Zubax/mitochondrik-evaluation-board-lv/docs/figures/MEB-LV-jig.png

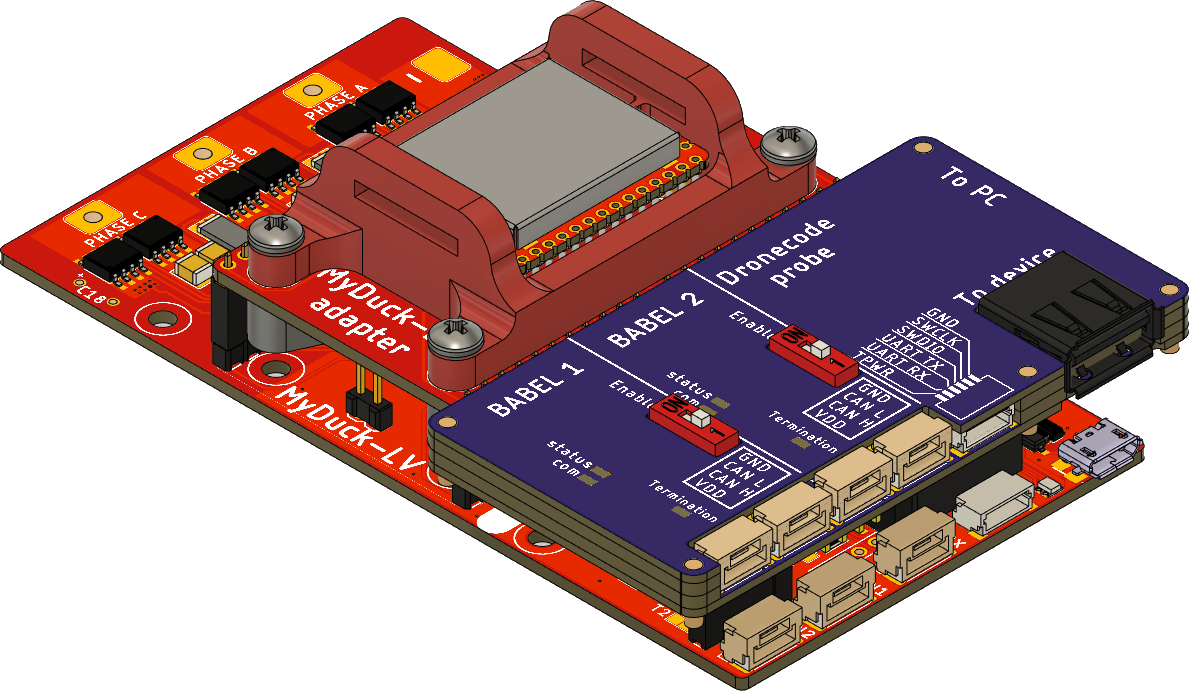
docs/figures/MEB-LV-jig.png
