Zubax/mitochondrik-evaluation-board-lv/figures/Myduck-LV-standalone.png

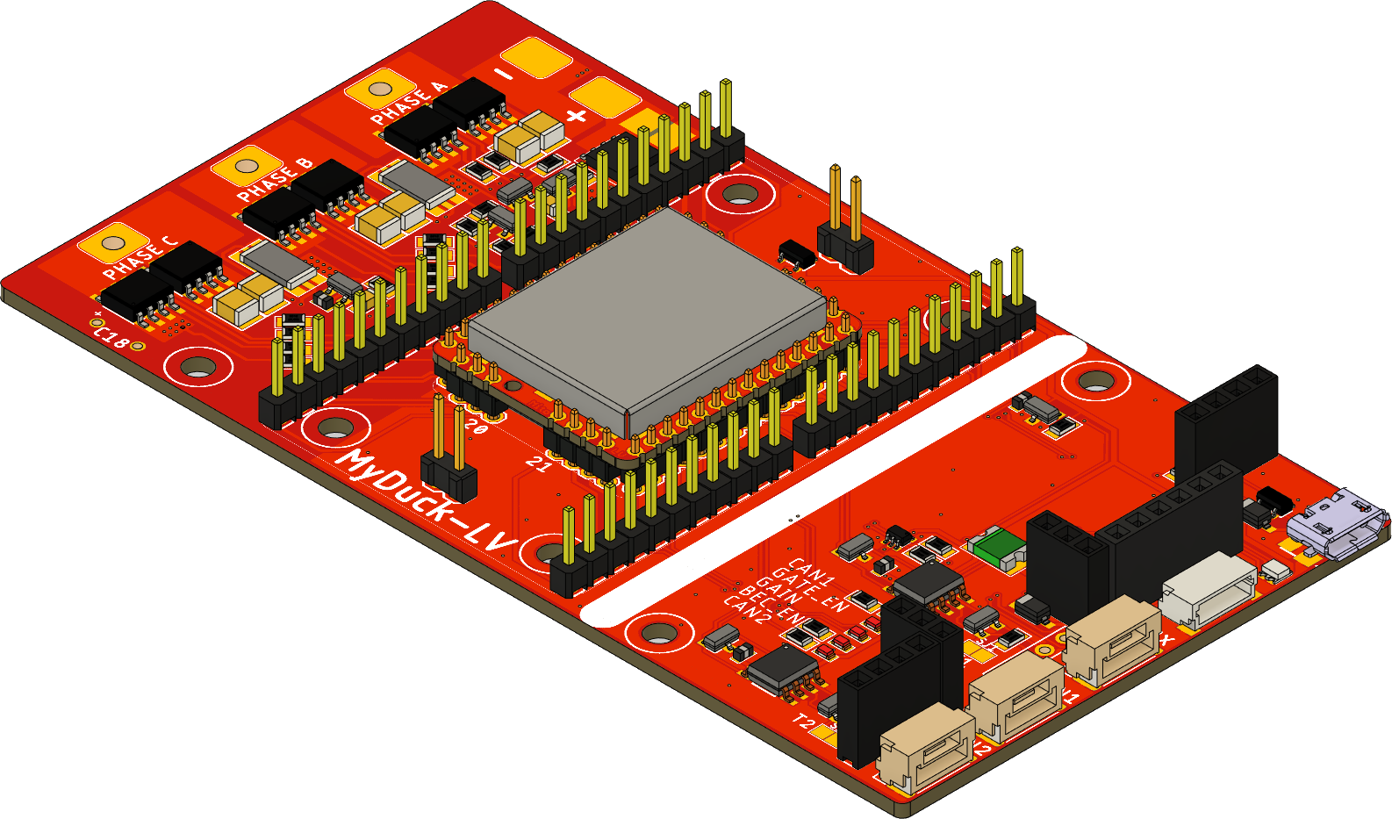
figures/Myduck-LV-standalone.png
