Zubax/mitochondrik-evaluation-board-lv/figures/toggle clamp.png

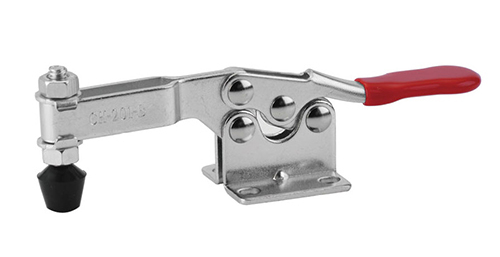
figures/toggle clamp.png
