Zubax/mitochondrik-evaluation-board-lv/3D/MEB_Holder_top.SLDPRT

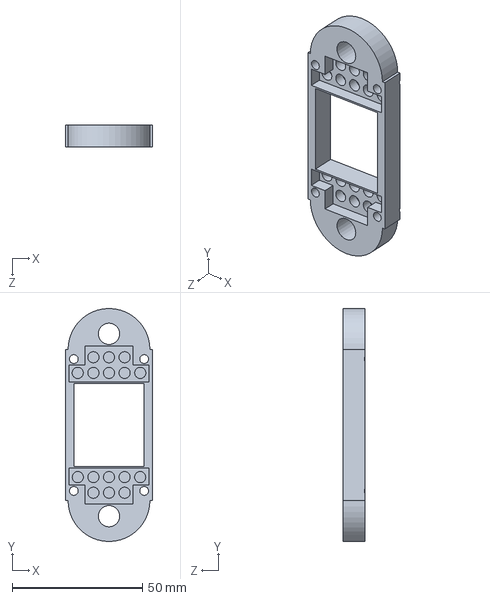
[picture p4: CAD file, 2023-08-01]
3D/MEB_Holder_top.SLDPRT
33.5 x 89.4 x 8.50 mm
