Zubax/mitochondrik-evaluation-board-lv/3D/MEB-Pogo-jig.SLDPRT

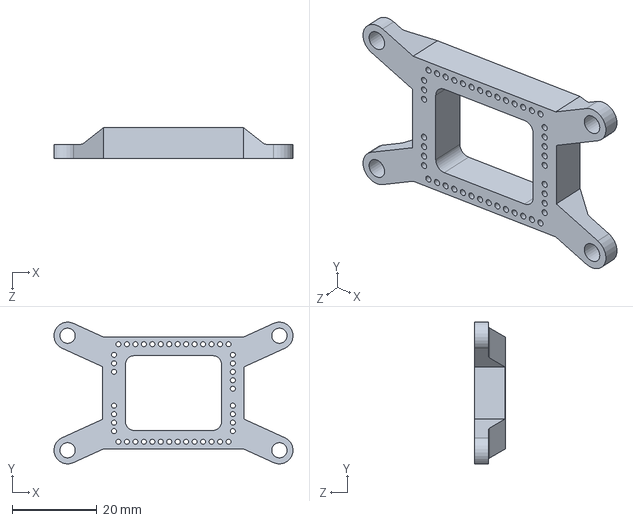
[picture p5: CAD file, 2023-05-10]
3D/MEB-Pogo-jig.SLDPRT
56.4 x 33.4 x 7.20 mm
