Zubax/mitochondrik-evaluation-board-lv/3D/MK_Holder_bottom.SLDPRT

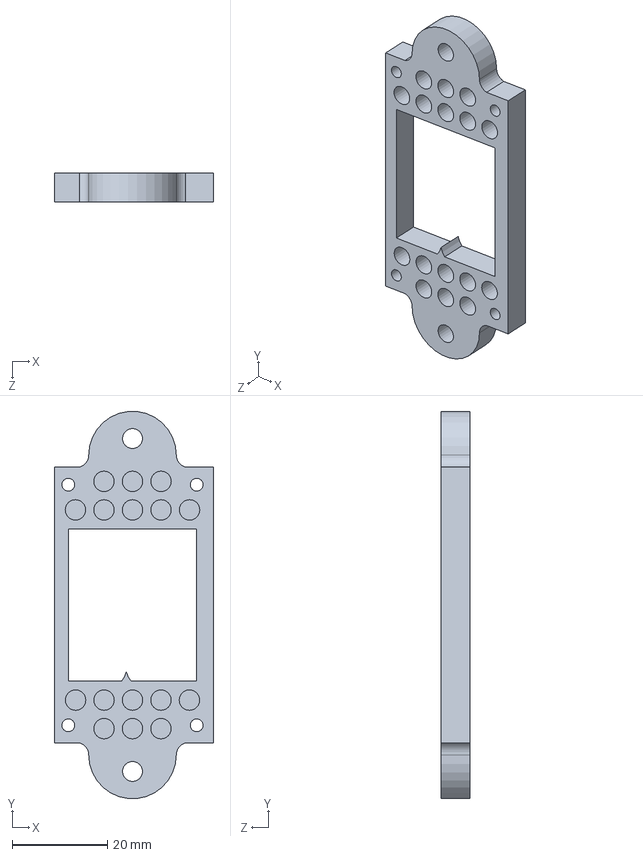
[picture p6: CAD file, 2023-03-03]
3D/MK_Holder_bottom.SLDPRT
33.5 x 81.4 x 6.00 mm
