Zubax/mitochondrik-evaluation-board-lv/docs/manufacturing.md

# Manufacturing instructions

## Evaluation board (customer variant)
Mitochondrik Evaluation Board LV can be used as an evaluation board for Mitochondrik LV. In this scenario, Mitochondrik LV is soldered 
directly to the PCB, turning Mitochondrik Evaluation Board LV into a debug-friendly evaluation board or a PMSM motor controller.

<p align="center">

</p>

To manufacture the device as an evaluation board, only the main PCB should be assembled.
The main PCB should be used to generate BOM and PnP files.
In addition, the DC link capacitor should be soldered beside `CON19` on the main PCB.
The RGB LED should be installed in the correct orientation. The reference photo can be seen below:

<p align="center">

</p>

As the mitochondrik footprint is populated using PLS2 male connectors,
the module installed on the PCB should be equipped with appropriate mating connectors.
The reference photo can be seen below.

<p align="center">

</p>

## Evaluation board with Babel-Babel (customer variant)
Same as above but with an integrated Babel-Babel. The footprint is populated using PLS 2.54 mm male connectors.
Ensure that Babel-Babel is parallel to the evaluation board when soldering.
The reference photo can be seen below.

<p align="center">
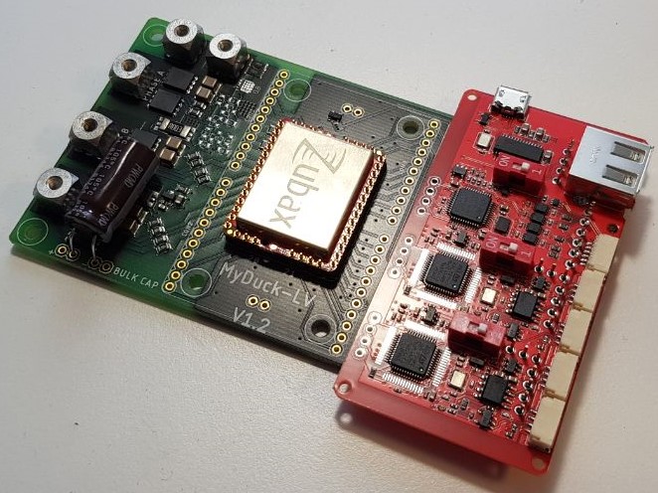
[picture p9: docs/figures/MEB-LV-EVAL-BB.jpeg]

</p>

## Production tool (manufacturer variant)

Mitochondrik Evaluation Board LV can serve as a tool for production flashing and testing of Mitochondrik LV (line checkout fixture).
In this scenario, the main board is assembled almost identically (mind the different assembly variant), and Mitochondrik LV is mounted on an intermediate PCB using pogo pins.
This PCB is then installed into Mitochondrik Evaluation Board LV.
Mitochondrik LV can be aligned in place using 3D-printed parts as explained below.
Mitochondrik Evaluation Board LV is designed to accept the [Babel-Babel debugging tool](https://github.com/Zubax/Babel-Babel) directly.

<p align="center">
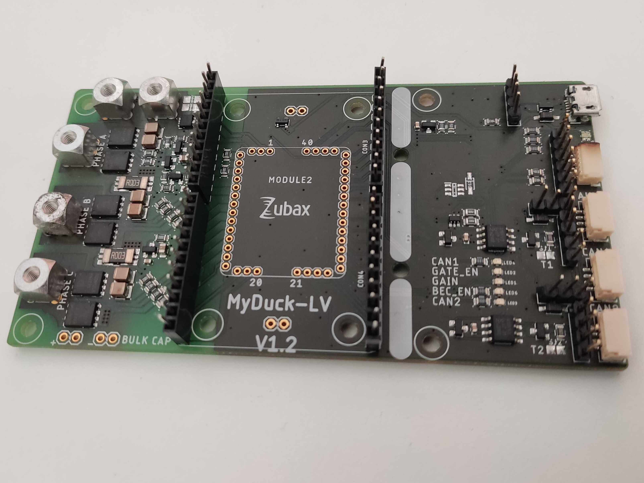
[picture p10: docs/figures/v1.2.jpg]


</p>

To use the device as a production tool, two PCBs should be manufactured. The main PCB should be used to generate
BOM and PnP files.

Besides that, the adapter PCB should also be manufactured. 
Solder 2 mm header pins & pogo pins to the adapter PCB.
It is permitted to use active flux for soldering the pogo pins; the part must be cleaned afterward.
Do not solder top-side pogo pins above the testpoints.

<p align="center">

</p>

A fully assembled adapter PCB can be seen in the pictures below.

<p align="center">
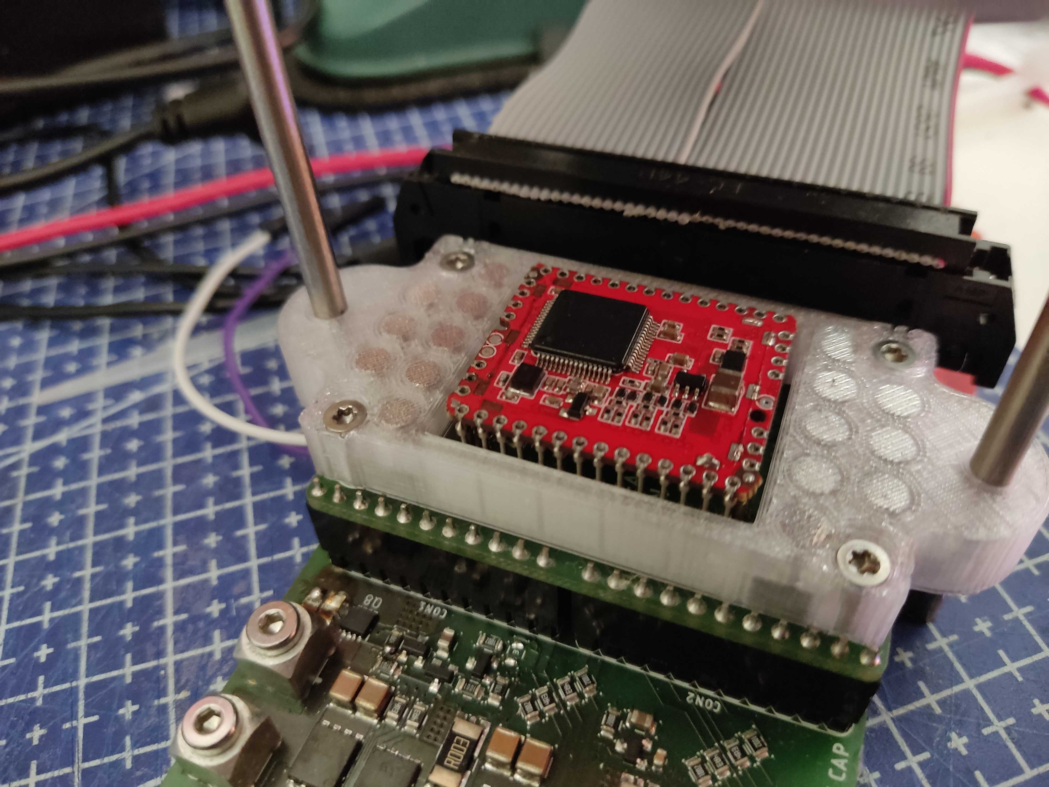
[picture p11: docs/figures/bottom-adapter.jpg]


</p>

Besides the 4x PBS11 connectors, the PCB also contains 44 pogo pins and a 3D-printed holder for the Mitochondrik module.
The pogo pins should be installed perpendicular to the surface of the PCB at the correct height.
As it may be tricky to do it by hand, it is recommended to use a special 3D-printed tool.
It can be seen in the picture below.

<p align="center">

</p>

The tool should be placed UNDER the PCB and aligned with all the holes on the PCB.
It can be temporarily fixed in place using M3 screws.
After that, the pins can be pushed into the tool through the PCB from the top.
The pins should be pushed until the lower tip of the pin is flush with the lower surface of the tool
(this guarantees the correct height of the pin relative to the top surface of the PCB).
After that, the pins can be soldered from the top side of the PCB.
The tool is single-use and cannot be removed from the device after the pins are mounted.
After the pogo pins are installed, the 3D-printed holder should be secured in place using 4x 8-12 mm M3 screws
and 4x M3 nuts.

The adapter set up can be seen below.

<p align="center">

</p>

Insert 4x4 mm magnets into the 3D Holders such that their magnetization direction alternates. 
Ensure that the top and bottom magnets attract each other.
Add 2 thin steel sheets to cover the magnet and close the flux.
Bolt the 3D Bottom Holder to the adapter board with 4x M3 screws from underneath. 
The steel plate should be in between the 3D holders and the adapter PCB.
Insert 4 mm metallic rods on both sides of the 3D Bottom Holder.
Assemble the second adapter board with pogo pins facing the opposite direction.
Ensure that the pogo pins of the top and bottom parts can make contact with each other
when the top part is pushed all the way down.
Bolt the 3D Top Holder to the second adapter board with 4x M3 screws from the top.
Insert linear bearings into the outer holes of the 3D Top Holder and apply glue.
Insert the 3D Top Holder and second adapter board assembly through the 4 mm metallic rods.
Connect the top and bottom adapter boards with a 1.27mm ribbon cable.

### BOM for final assembly of Mitochondrik Evaluation Board LV (customer variant)

| Name | Quantity |
| --- | --- |
| Mitochondrik Evaluation Board LV PCB | 1 |
| Mitochondrik LV | 1 |
| DC Link Capacitor: United Chemi-Con ELXZ630ELL821MK40S or Nichicon UPW1J221MPD1TD | 1 |
| PLS 2 mm male pin headers | 44 pins total | 
| PLS 2.54 mm male pin headers | 24 pins total |
| Babel-Babel (only for BB variant) | 1 | 

### BOM for final assembly of Mitochondrik Evaluation Board LV as production tool (manufacturer variant)

| Name | Quantity |
| --- | --- |
| Adapter assembly (Top & Bottom) | 2 |
| Mitochondrik Evaluation Board LV PCB | 1 |
| DC Link Capacitor: United Chemi-Con ELXZ630ELL821MK40S or Nichicon UPW1J221MPD1TD | 1 |
| PBS11 male connectors | 4 |
| PLS 2.54 mm male pin headers | 24 pins total |
| Babel-Babel | 1 |
| 4 mm linear guide | 2 |
| 4 mm linear bearing | 2 |
| 44 pin Ribbon connector | 1 |

### BOM required for the manufacturing of Top Adapter assembly

| Name | Quantity |
| --- | --- |
| Pogo pins soldering tool | 1 |  
| Pogo pins | 44 |
| Adapter PCB | 1 |
| 4x4 mm cylindrical axially-magnetized Neodymium magnets | 16 |
| 18x12.5x0.5 mm steel sheets | 2 |
| 3D Top Holder | 1 |
| M3 x 12mm screw | 4 | 
| M3 nut | 4 |

### BOM required for the manufacturing of Bottom Adapter assembly

| Name | Quantity |
| --- | --- |
| 3D Bottom Holder | 1 |
| 4x4 mm cylindrical axially-magnetized Neodymium magnets | 16 |
| 18x12.5x0.5 mm steel sheets | 2 |
| Adapter PCB | 1 |
| Pogo pins | 44 |
| Pogo pins soldering tool | 1 |  
| PBS11 female connectors  | 4 |
| M3 x 12mm screw | 4 | 
| M3 nut | 4 |
