Zubax/mitochondrik-evaluation-board-lv/src/adapter.brd

## EAGLE design src/adapter.brd (2023-05-10)

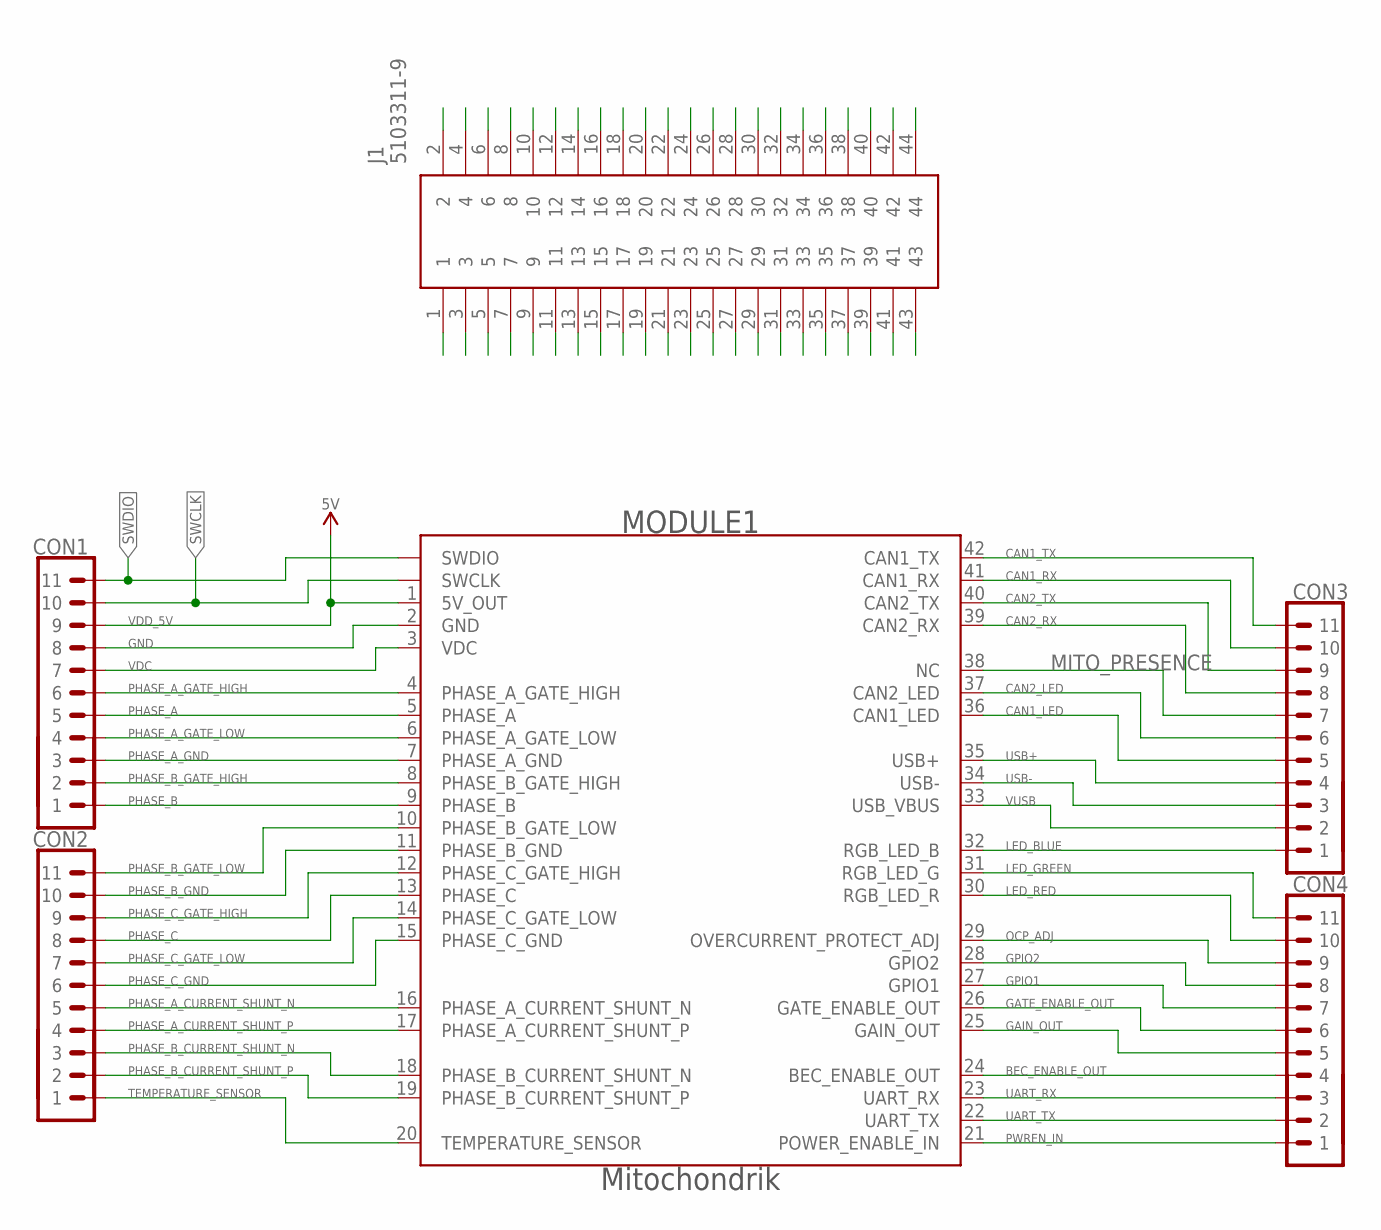
[picture p12: schematic adapter.sch, Mitochondrik]

Parts:
CON1, CON2, CON3, CON4: PINHEAD_1X11-2.54_STRAIGHT_FEMALE; 1X11-PTH-2.54-FEMALE; DIGIKEY# S7009-ND
J1: 5103311-9; SHDRRA44W66P254_2X22_6337X986X
MODULE1: MITOHONDRIQUE_POGO-POGO; MITOHONDRIQUE-POGO

Connections:
BEC_ENABLE_OUT: CON4.4, J1.37, MODULE1.24 (BEC_ENABLE_OUT)
CAN1_LED: CON3.5, J1.13, MODULE1.36 (CAN1_LED)
CAN1_RX: CON3.10, J1.3, MODULE1.41 (CAN1_RX)
CAN1_TX: CON3.11, J1.1, MODULE1.42 (CAN1_TX)
CAN2_LED: CON3.6, J1.11, MODULE1.37 (CAN2_LED)
CAN2_RX: CON3.8, J1.7, MODULE1.39 (CAN2_RX)
CAN2_TX: CON3.9, J1.5, MODULE1.40 (CAN2_TX)
GAIN_OUT: CON4.5, J1.35, MODULE1.25 (GAIN_OUT)
GATE_ENABLE_OUT: CON4.6, J1.33, MODULE1.26 (GATE_ENABLE_OUT)
GND: CON1.8, J1.8, MODULE1.2 (GND)
GPIO1: CON4.7, J1.31, MODULE1.27 (GPIO1)
GPIO2: CON4.8, J1.29, MODULE1.28 (GPIO2)
LED_BLUE: CON3.1, J1.21, MODULE1.32 (RGB_LED_B)
LED_GREEN: CON4.11, J1.23, MODULE1.31 (RGB_LED_G)
LED_RED: CON4.10, J1.25, MODULE1.30 (RGB_LED_R)
MITO_PRESENCE: CON3.7, J1.9, MODULE1.38 (NC)
OCP_ADJ: CON4.9, J1.27, MODULE1.29 (OVERCURRENT_PROTECT_ADJ)
PHASE_A: CON1.5, J1.14, MODULE1.5 (PHASE_A)
PHASE_A_CURRENT_SHUNT_N: CON2.5, J1.36, MODULE1.16 (PHASE_A_CURRENT_SHUNT_N)
PHASE_A_CURRENT_SHUNT_P: CON2.4, J1.38, MODULE1.17 (PHASE_A_CURRENT_SHUNT_P)
PHASE_A_GATE_HIGH: CON1.6, J1.12, MODULE1.4 (PHASE_A_GATE_HIGH)
PHASE_A_GATE_LOW: CON1.4, J1.16, MODULE1.6 (PHASE_A_GATE_LOW)
PHASE_A_GND: CON1.3, J1.18, MODULE1.7 (PHASE_A_GND)
PHASE_B: CON1.1, J1.22, MODULE1.9 (PHASE_B)
PHASE_B_CURRENT_SHUNT_N: CON2.3, J1.40, MODULE1.18 (PHASE_B_CURRENT_SHUNT_N)
PHASE_B_CURRENT_SHUNT_P: CON2.2, J1.42, MODULE1.19 (PHASE_B_CURRENT_SHUNT_P)
PHASE_B_GATE_HIGH: CON1.2, J1.20, MODULE1.8 (PHASE_B_GATE_HIGH)
PHASE_B_GATE_LOW: CON2.11, J1.24, MODULE1.10 (PHASE_B_GATE_LOW)
PHASE_B_GND: CON2.10, J1.26, MODULE1.11 (PHASE_B_GND)
PHASE_C: CON2.8, J1.30, MODULE1.13 (PHASE_C)
PHASE_C_GATE_HIGH: CON2.9, J1.28, MODULE1.12 (PHASE_C_GATE_HIGH)
PHASE_C_GATE_LOW: CON2.7, J1.32, MODULE1.14 (PHASE_C_GATE_LOW)
PHASE_C_GND: CON2.6, J1.34, MODULE1.15 (PHASE_C_GND)
PWREN_IN: CON4.1, J1.43, MODULE1.21 (POWER_ENABLE_IN)
SWCLK: CON1.10, J1.4, MODULE1.SWCLK
SWDIO: CON1.11, J1.2, MODULE1.SWDIO
TEMPERATURE_SENSOR: CON2.1, J1.44, MODULE1.20 (TEMPERATURE_SENSOR)
UART_RX: CON4.3, J1.39, MODULE1.23 (UART_RX)
UART_TX: CON4.2, J1.41, MODULE1.22 (UART_TX)
USB+: CON3.4, J1.15, MODULE1.35 (USB+)
USB-: CON3.3, J1.17, MODULE1.34 (USB-)
VDC: CON1.7, J1.10, MODULE1.3 (VDC)
VDD_5V: CON1.9, J1.6, MODULE1.1 (5V_OUT)
VUSB: CON3.2, J1.19, MODULE1.33 (USB_VBUS)

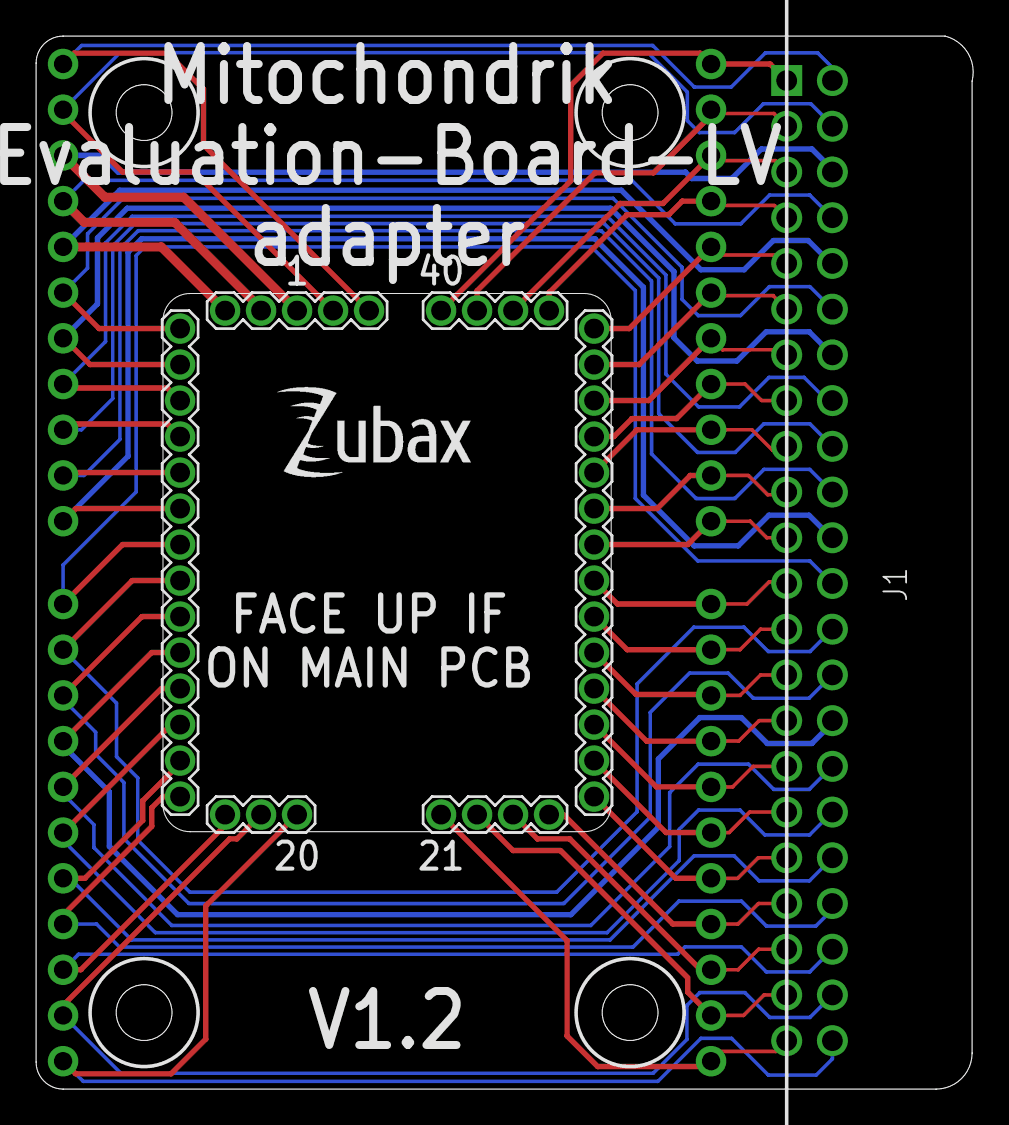
[picture p13: board adapter.brd from above]

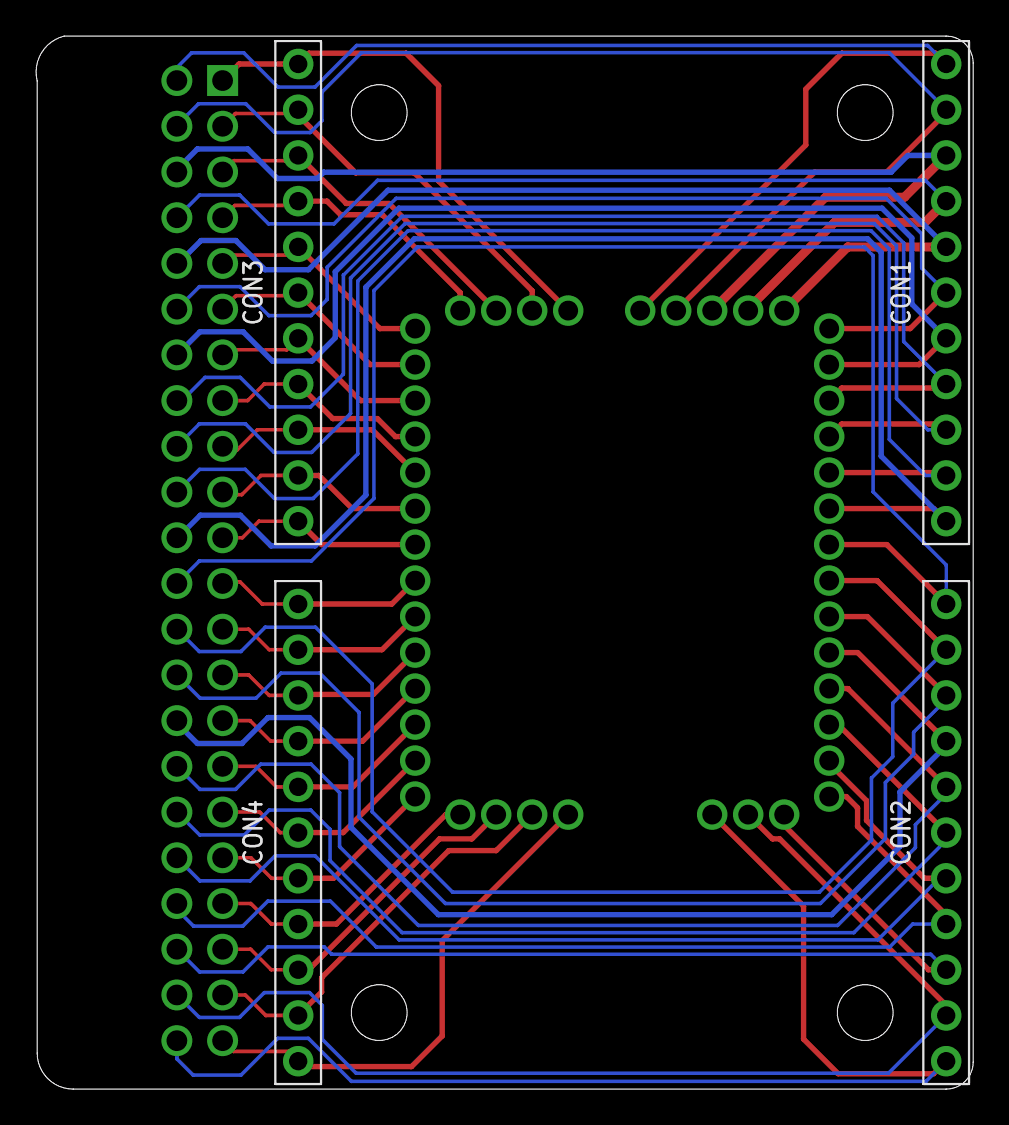
[picture p14: board adapter.brd from below]

Board: 2 copper layers, 52.1 x 58.5 mm, 7 parts (4 on the bottom side), 44 nets.

Other parts of the board:
U$2: ZUBAX_LOGO_5X10
