Zubax/mitochondrik-evaluation-board-lv/src/MyDuck-LV.brd

## EAGLE design src/MyDuck-LV.brd (2023-03-10)

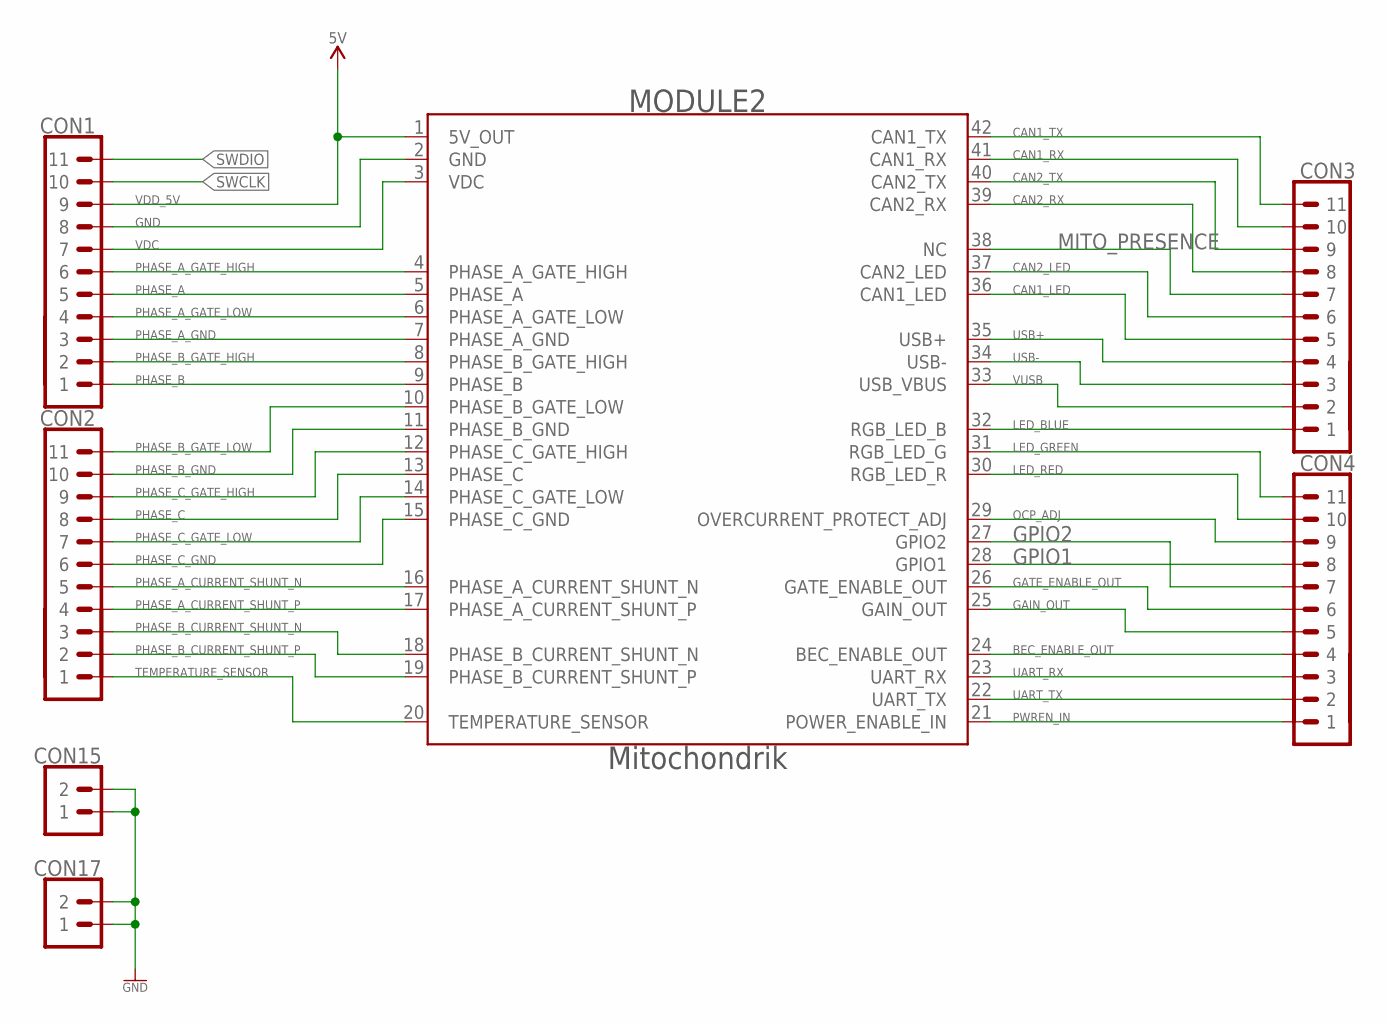
[picture p15: schematic MyDuck-LV.sch, sheet 1, Mitochondrik]

Parts:
CON1, CON2, CON3, CON4: PINHEAD_1X11-2.54_STRAIGHT_MALE; 1X11-PTH-2.54; DIGIKEY# S1022EC-11-ND
CON15, CON17: PINHEAD_1X02-2.54; 1X02-PTH-2.54; DIGIKEY# S1041E-02-ND
MODULE2: MITOCHONDRIK

Connections:
BEC_ENABLE_OUT: CON4.4, MODULE2.24 (BEC_ENABLE_OUT); also elsewhere on the board
CAN1_LED: CON3.5, MODULE2.36 (CAN1_LED); also elsewhere on the board
CAN1_RX: CON3.10, MODULE2.41 (CAN1_RX); also elsewhere on the board
CAN1_TX: CON3.11, MODULE2.42 (CAN1_TX); also elsewhere on the board
CAN2_LED: CON3.6, MODULE2.37 (CAN2_LED); also elsewhere on the board
CAN2_RX: CON3.8, MODULE2.39 (CAN2_RX); also elsewhere on the board
CAN2_TX: CON3.9, MODULE2.40 (CAN2_TX); also elsewhere on the board
GAIN_OUT: CON4.5, MODULE2.25 (GAIN_OUT); also elsewhere on the board
GATE_ENABLE_OUT: CON4.6, MODULE2.26 (GATE_ENABLE_OUT); also elsewhere on the board
GND: CON1.8, CON15.1, CON15.2, CON17.1, CON17.2, MODULE2.2 (GND); also elsewhere on the board
GPIO1: CON4.8, MODULE2.28 (GPIO1); also elsewhere on the board
GPIO2: CON4.7, MODULE2.27 (GPIO2); also elsewhere on the board
LED_BLUE: CON3.1, MODULE2.32 (RGB_LED_B); also elsewhere on the board
LED_GREEN: CON4.11, MODULE2.31 (RGB_LED_G); also elsewhere on the board
LED_RED: CON4.10, MODULE2.30 (RGB_LED_R); also elsewhere on the board
MITO_PRESENCE: CON3.7, MODULE2.38 (NC); also elsewhere on the board
OCP_ADJ: CON4.9, MODULE2.29 (OVERCURRENT_PROTECT_ADJ)
PHASE_A: CON1.5, MODULE2.5 (PHASE_A); also elsewhere on the board
PHASE_A_CURRENT_SHUNT_N: CON2.5, MODULE2.16 (PHASE_A_CURRENT_SHUNT_N); also elsewhere on the board
PHASE_A_CURRENT_SHUNT_P: CON2.4, MODULE2.17 (PHASE_A_CURRENT_SHUNT_P); also elsewhere on the board
PHASE_A_GATE_HIGH: CON1.6, MODULE2.4 (PHASE_A_GATE_HIGH); also elsewhere on the board
PHASE_A_GATE_LOW: CON1.4, MODULE2.6 (PHASE_A_GATE_LOW); also elsewhere on the board
PHASE_A_GND: CON1.3, MODULE2.7 (PHASE_A_GND); also elsewhere on the board
PHASE_B: CON1.1, MODULE2.9 (PHASE_B); also elsewhere on the board
PHASE_B_CURRENT_SHUNT_N: CON2.3, MODULE2.18 (PHASE_B_CURRENT_SHUNT_N); also elsewhere on the board
PHASE_B_CURRENT_SHUNT_P: CON2.2, MODULE2.19 (PHASE_B_CURRENT_SHUNT_P); also elsewhere on the board
PHASE_B_GATE_HIGH: CON1.2, MODULE2.8 (PHASE_B_GATE_HIGH); also elsewhere on the board
PHASE_B_GATE_LOW: CON2.11, MODULE2.10 (PHASE_B_GATE_LOW); also elsewhere on the board
PHASE_B_GND: CON2.10, MODULE2.11 (PHASE_B_GND); also elsewhere on the board
PHASE_C: CON2.8, MODULE2.13 (PHASE_C); also elsewhere on the board
PHASE_C_GATE_HIGH: CON2.9, MODULE2.12 (PHASE_C_GATE_HIGH); also elsewhere on the board
PHASE_C_GATE_LOW: CON2.7, MODULE2.14 (PHASE_C_GATE_LOW); also elsewhere on the board
PHASE_C_GND: CON2.6, MODULE2.15 (PHASE_C_GND); also elsewhere on the board
PWREN_IN: CON4.1, MODULE2.21 (POWER_ENABLE_IN)
SWCLK: CON1.10; also elsewhere on the board
SWDIO: CON1.11; also elsewhere on the board
TEMPERATURE_SENSOR: CON2.1, MODULE2.20 (TEMPERATURE_SENSOR); also elsewhere on the board
UART_RX: CON4.3, MODULE2.23 (UART_RX); also elsewhere on the board
UART_TX: CON4.2, MODULE2.22 (UART_TX); also elsewhere on the board
USB+: CON3.4, MODULE2.35 (USB+); also elsewhere on the board
USB-: CON3.3, MODULE2.34 (USB-); also elsewhere on the board
VDC: CON1.7, MODULE2.3 (VDC); also elsewhere on the board
VDD_5V: CON1.9, MODULE2.1 (5V_OUT); also elsewhere on the board
VUSB: CON3.2, MODULE2.33 (USB_VBUS); also elsewhere on the board

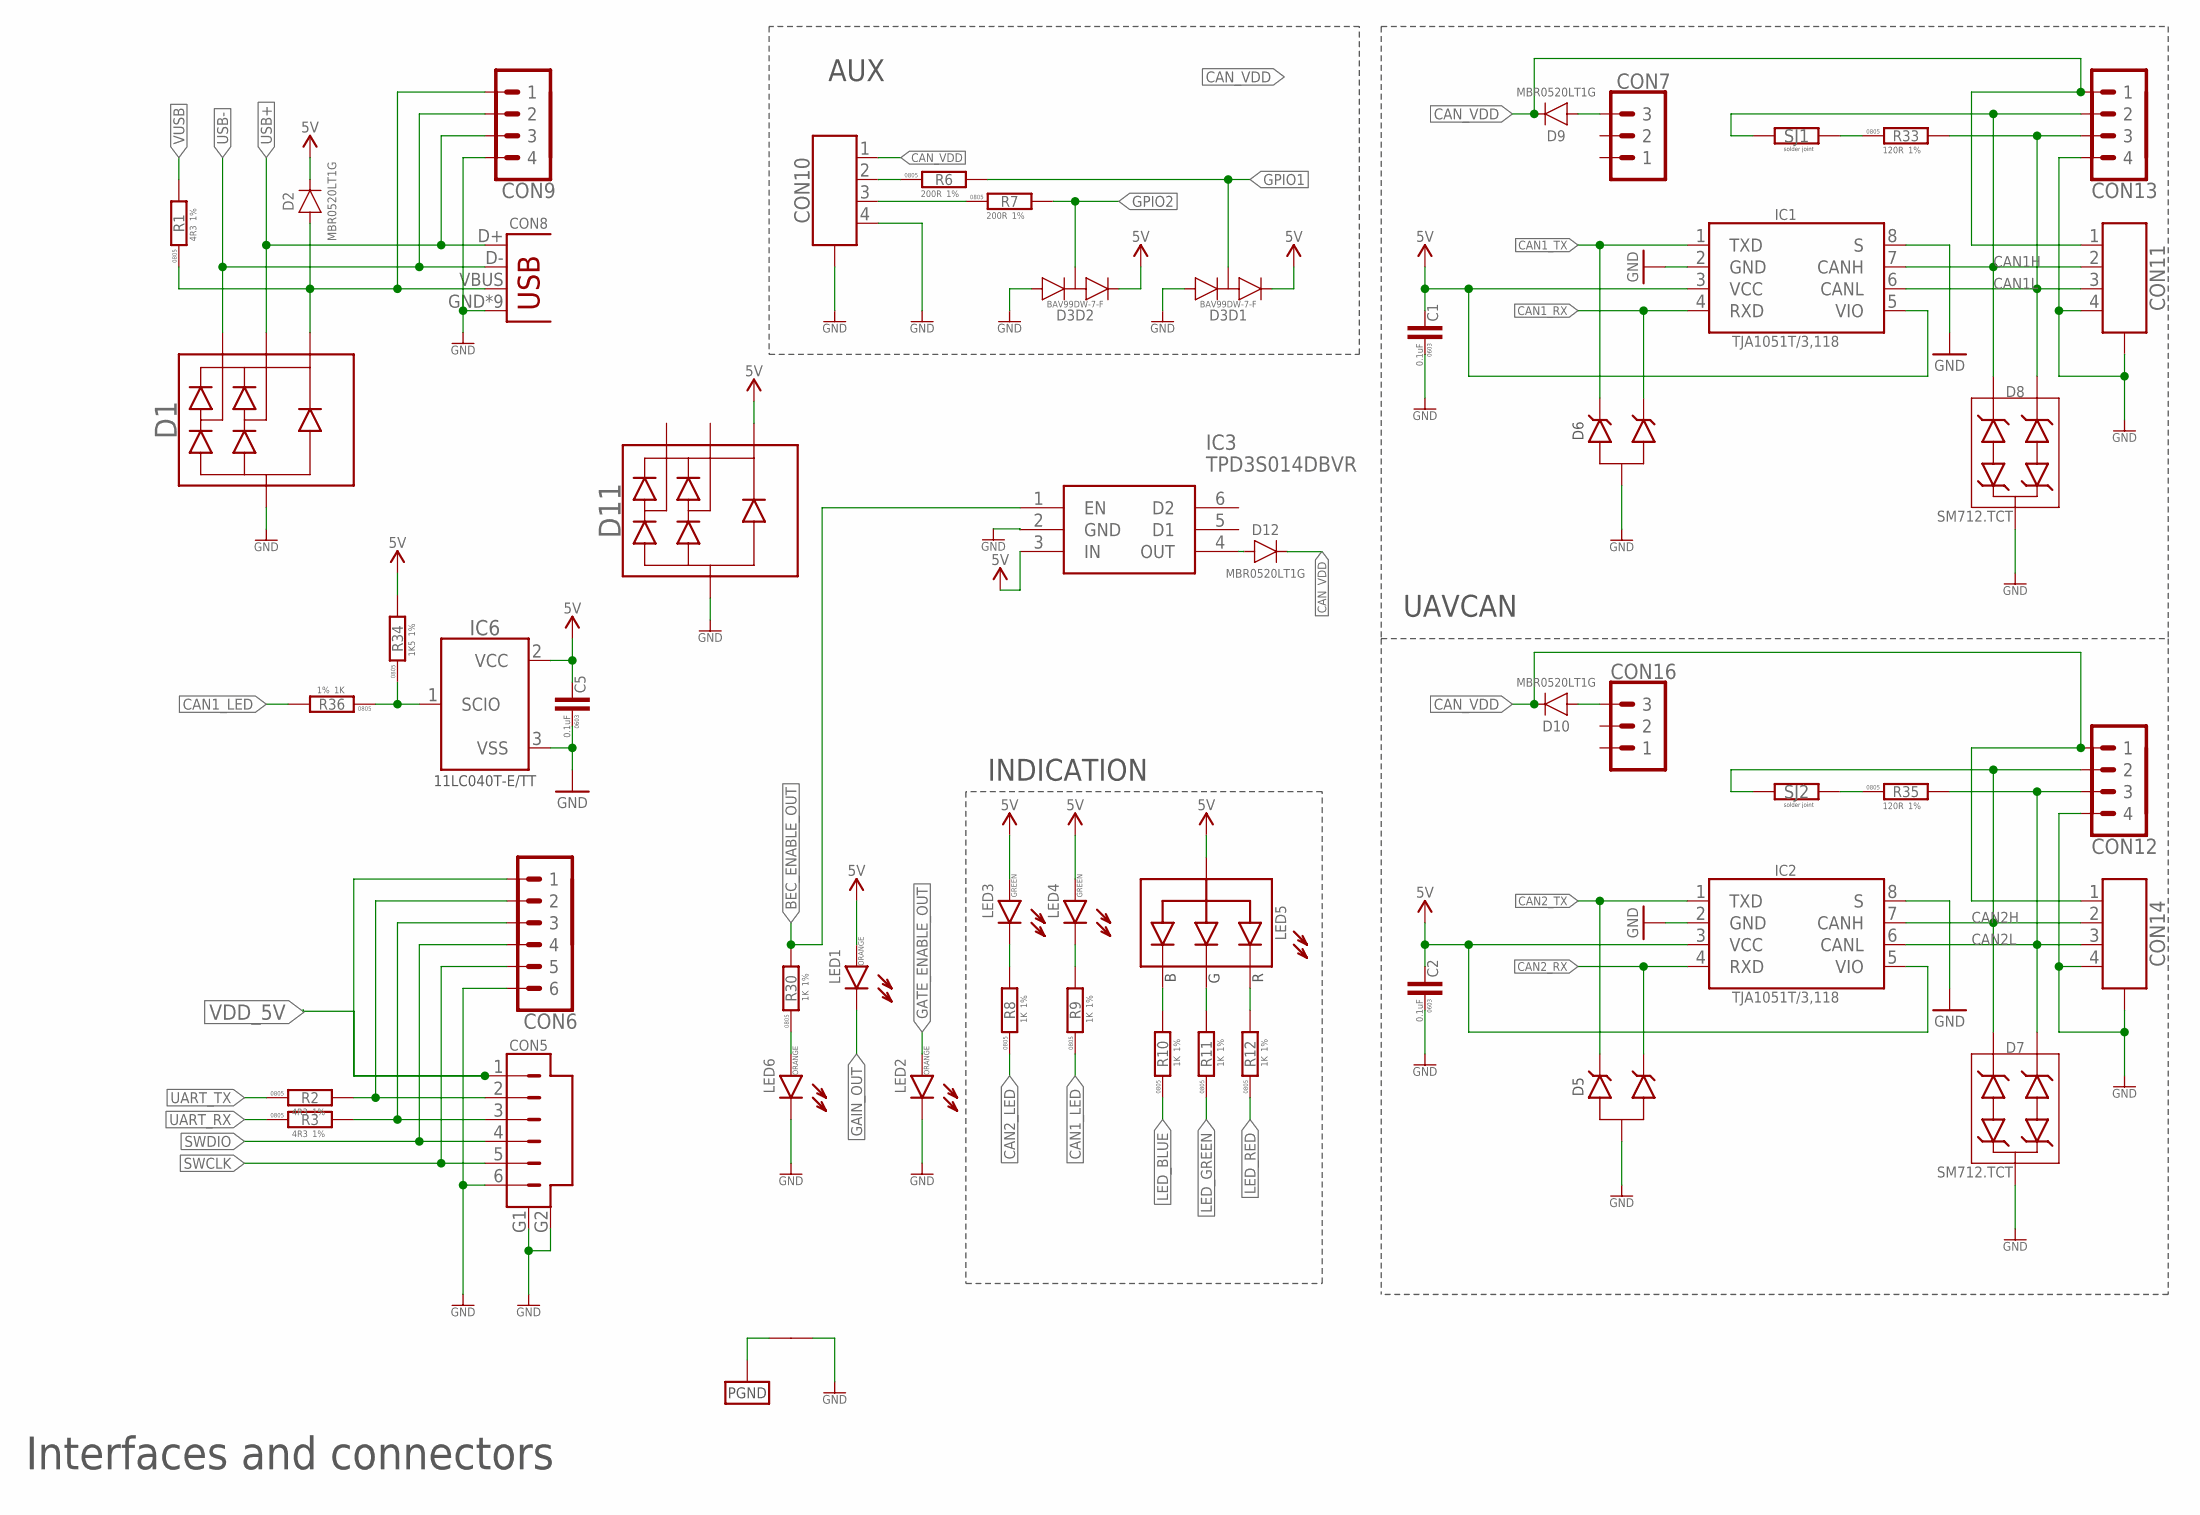
[picture p16: schematic MyDuck-LV.sch, sheet 2, Interfaces]

Parts:
C1, C2, C5: 0.1uF; C0603; DIGIKEY# 1276-1938-1-ND
CON5: CON-6P-SM06B; SM06B
CON6: PINHEAD_1X06-2.54-FEMALE; 1X06-PTH-2.54-FEMALE
CON7, CON16: PINHEAD_1X03-PBS3; PBS3
CON8: USB-1; -10118193-0001LF
CON9, CON12, CON13: PINHEAD_1X04-PBS4; PBS4
CON10, CON11, CON14: CON-4P-TABS-JST_GH-RA; JST_GH-4P-RA
D1, D11: PRTR5V0U2X; SOT143B
D2, D9, D10, D12: MBR0520L-SOD123; SOD123
D3: BAV99DW; SOT363
D5, D6: ESDA6V1L; SOT23B-3
D7, D8: SM712; SOT23B-3
IC1, IC2: TJA1051-SO8; SOIC8
IC3: TPD3S014DBVR; SOT95P280X145-6N
IC6: 11LC040T-E/TT; SOT23B-3
J1: CONNECTION-SMD; CONNECTION
LED1, LED2, LED6: ORANGE; LED0603; DIGIKEY# 754-1120-1-ND
LED3, LED4: GREEN; LED0603; DIGIKEY# 754-1116-1-ND
LED5: LTST-C19HE1WT; 0606
R1: 4R3; R0805
R2, R3: 4R3; R0805; DIGIKEY# 311-4.3ARTR-ND
R6, R7: 200R; R0805
R8, R9, R10, R11, R12, R30, R36: 1K; R0805; DIGIKEY# YAG1240CT-ND
R33, R35: 120R; R0805; DIGIKEY# 311-120CRCT-ND
R34: 1K5; R0805
SJ1, SJ2: SOLDER_JOINT; RES_0

Connections:
BEC_ENABLE_OUT: IC3.1 (EN), R30.2; also elsewhere on the board
CAN1H: CON11.2, CON13.2, D8.1 (C3), IC1.7 (CANH), SJ1.1
CAN1L: CON11.3, CON13.3, D8.2 (C2), IC1.6 (CANL), R33.2
CAN1_LED: R9.1, R36.2; also elsewhere on the board
CAN1_RX: D6.2 (C1), IC1.4 (RXD); also elsewhere on the board
CAN1_TX: D6.1 (C), IC1.1 (TXD); also elsewhere on the board
CAN2H: CON12.2, CON14.2, D7.1 (C3), IC2.7 (CANH), SJ2.1
CAN2L: CON12.3, CON14.3, D7.2 (C2), IC2.6 (CANL), R35.2
CAN2_LED: R8.1; also elsewhere on the board
CAN2_RX: D5.2 (C1), IC2.4 (RXD); also elsewhere on the board
CAN2_TX: D5.1 (C), IC2.1 (TXD); also elsewhere on the board
CAN_VDD: CON10.1, CON11.1, CON12.1, CON13.1, CON14.1, D9.C, D10.C, D12.C; also elsewhere on the board
GAIN_OUT: LED1.C; also elsewhere on the board
GATE_ENABLE_OUT: LED2.A; also elsewhere on the board
GND: C1.1, C2.1, C5.1, CON5.6, CON5.G1, CON5.G2, CON6.6, CON8.GND, CON8.GND1 (GND), CON8.GND2 (GND), CON8.GND3 (GND), CON8.GND4 (GND), CON8.P$1 (GND), CON8.P$2 (GND), CON8.P$3 (GND), CON8.P$4 (GND), CON9.4, CON10.4, CON10.M$0 (GND), CON10.M$1 (GND), CON11.4, CON11.M$0 (GND), CON11.M$1 (GND), CON12.4, CON13.4, CON14.4, CON14.M$0 (GND), CON14.M$1 (GND), D1.1 (C), D3.1 (A), D3.4 (A), D5.3 (A), D6.3 (A), D7.3, D8.3, D11.1 (C), IC1.2 (GND), IC1.8 (S), IC2.2 (GND), IC2.8 (S), IC3.2 (GND), IC6.3 (VSS), J1.P$2, LED2.C, LED6.C; also elsewhere on the board
GPIO1: D3.6 (COMMON), R6.2; also elsewhere on the board
GPIO2: D3.3 (COMMON), R7.2; also elsewhere on the board
LED_BLUE: R10.1; also elsewhere on the board
LED_GREEN: R11.1; also elsewhere on the board
LED_RED: R12.1; also elsewhere on the board
unnamed: LED6.A, R30.1
unnamed: CON7.3, D9.A
unnamed: CON16.3, D10.A
unnamed: CON5.2, CON6.2, R2.2
unnamed: D12.A, IC3.4 (OUT)
unnamed: LED4.C, R9.2
unnamed: LED3.C, R8.2
unnamed: R33.1, SJ1.2
unnamed: CON10.2, R6.1
unnamed: R35.1, SJ2.2
unnamed: CON10.3, R7.1
unnamed: LED5.R, R12.2
unnamed: LED5.G, R11.2
unnamed: LED5.B, R10.2
unnamed: CON5.3, CON6.3, R3.2
OIUOIUIOU: IC6.1 (SCIO), R34.1, R36.1
PGND: J1.P$1; also elsewhere on the board
SWCLK: CON5.5, CON6.5; also elsewhere on the board
SWDIO: CON5.4, CON6.4; also elsewhere on the board
UART_RX: R3.1; also elsewhere on the board
UART_TX: R2.1; also elsewhere on the board
USB+: CON8.D+, CON9.3, D1.3 (D2); also elsewhere on the board
USB-: CON8.D-, CON9.2, D1.2 (D1); also elsewhere on the board
USB_VBUS: CON8.VBUS, CON9.1, D1.4 (A), D2.A, R1.1
VDD_5V: C1.2, C2.2, C5.2, CON5.1, CON6.1, D2.C, D3.2 (C), D3.5 (C), D11.4 (A), IC1.3 (VCC), IC1.5 (VIO), IC2.3 (VCC), IC2.5 (VIO), IC3.3 (IN), IC6.2 (VCC), LED1.A, LED3.A, LED4.A, LED5.+ (A), R34.2; also elsewhere on the board
VUSB: R1.2; also elsewhere on the board

Notes on the sheet:
Interfaces and connectors
UAVCAN
AUX
INDICATION

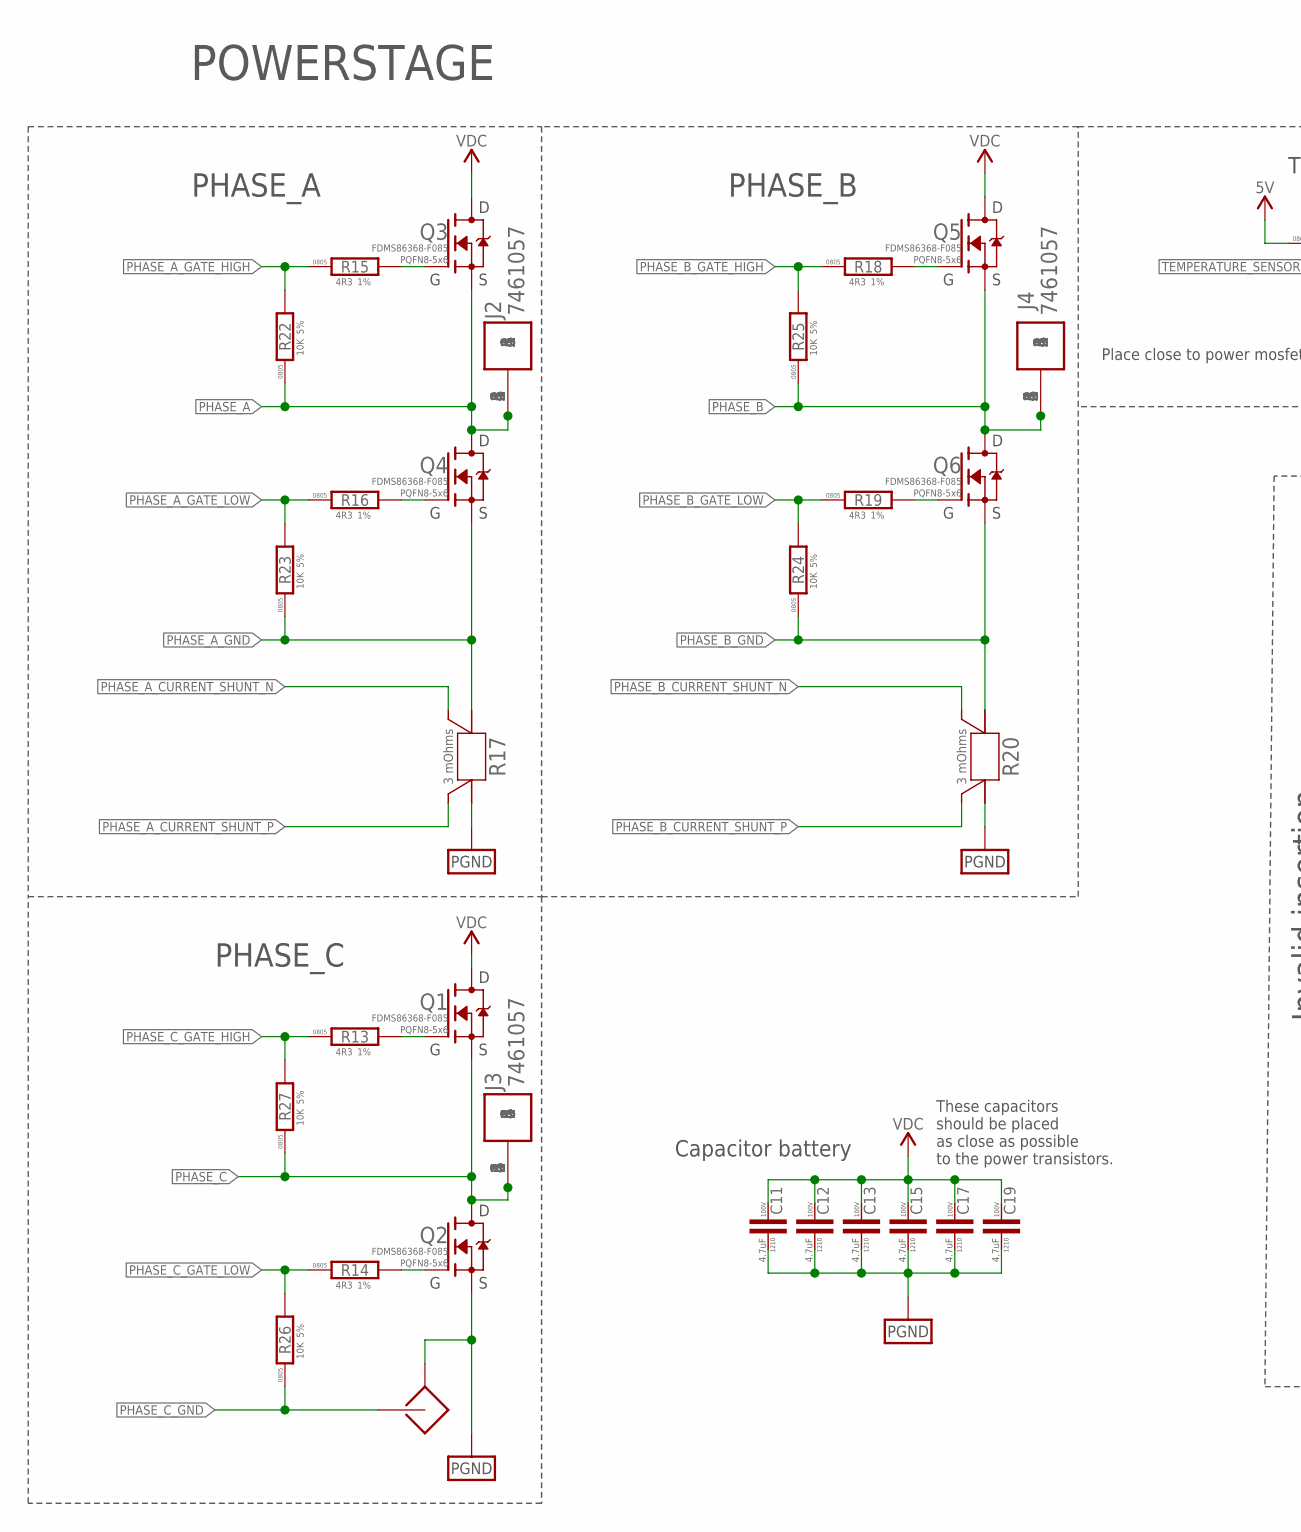
[picture p17: schematic MyDuck-LV.sch, sheet 3, Powerstage, part in row 1, column 1]

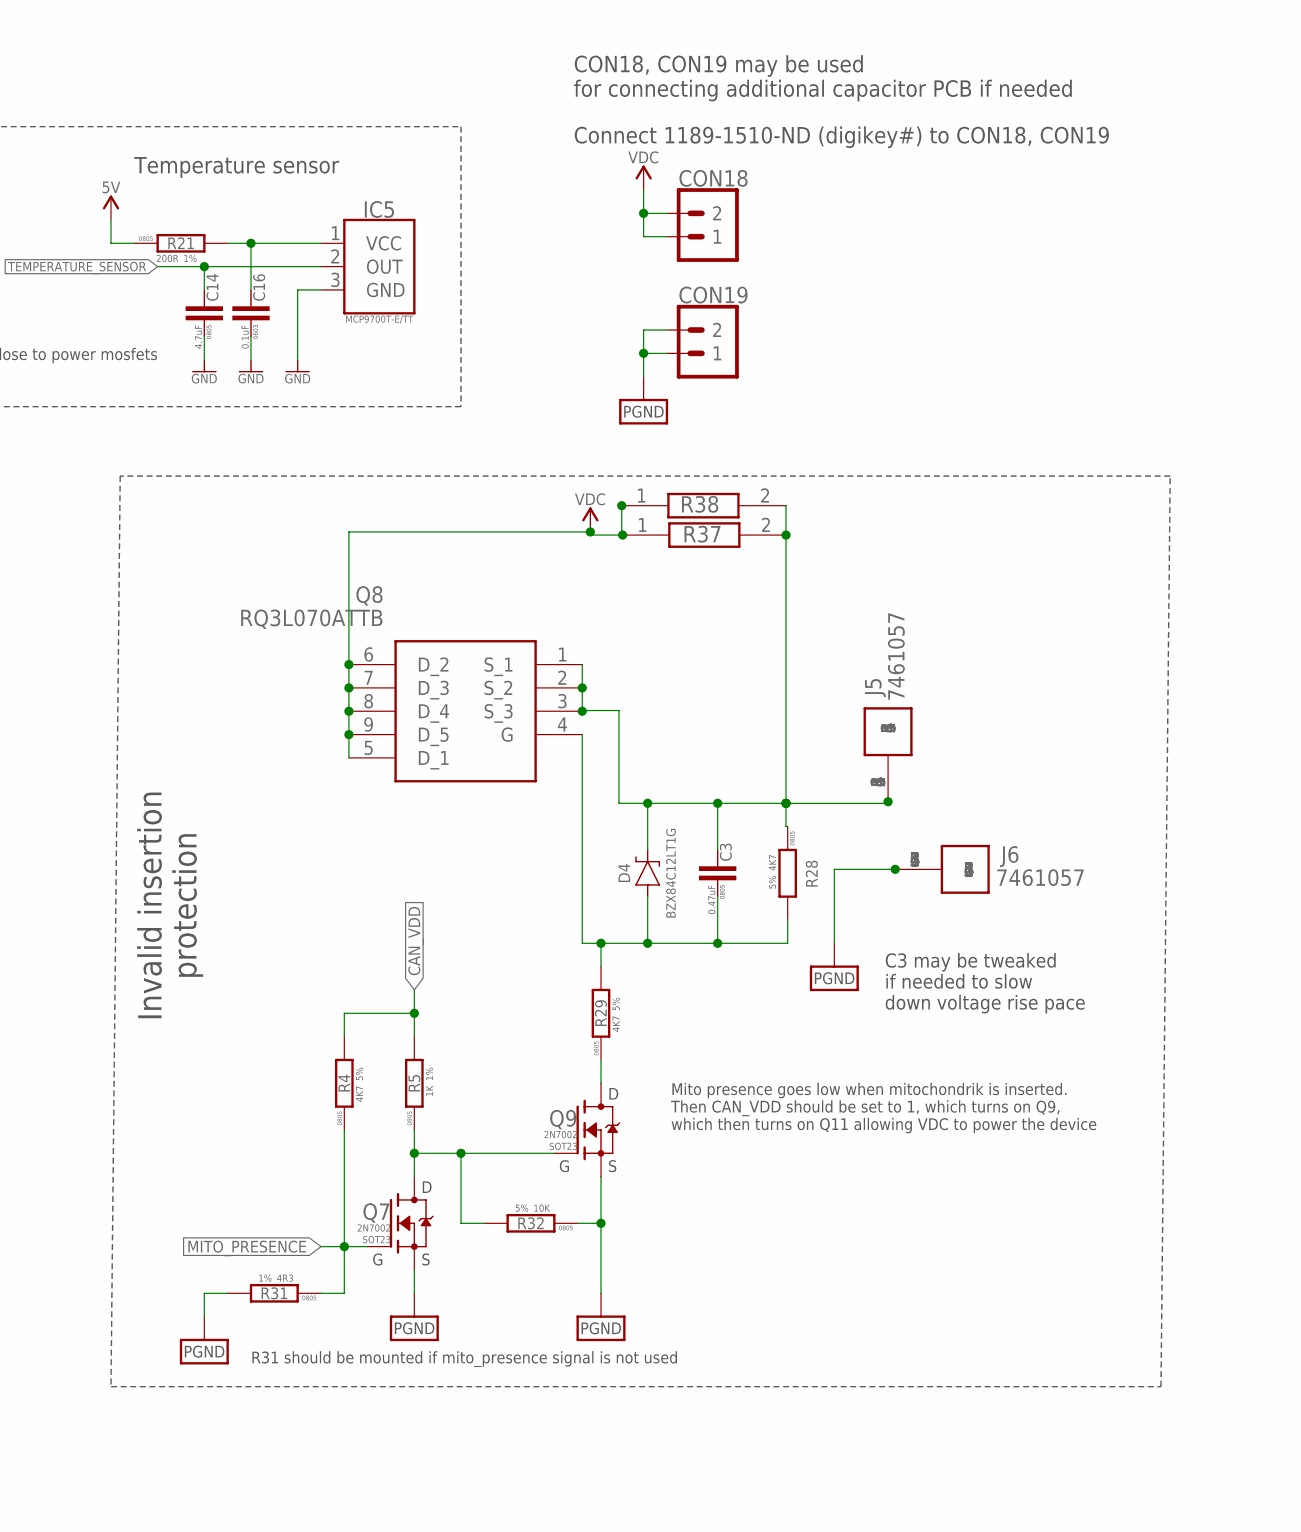
[picture p18: schematic MyDuck-LV.sch, sheet 3, Powerstage, part in row 1, column 2]

Parts:
C3: 0.47uF; C0805
C11, C12, C13, C15, C17, C19: 4.7uF; C1210; VOLTAGE 100V; DIGIKEY# 490-14484-1-ND
C14: 4.7uF; C0805; DIGIKEY# 1276-2415-1-ND
C16: 0.1uF; C0603; DIGIKEY# 1276-1938-1-ND
CON18, CON19: PINHEAD_1X02-2.54; 1X02-PTH-2.54
D4: BZX84C12; SOT23
IC5: MCP9700T-E/TT-SOT23; SOT23B-3
J2, J3, J4, J5, J6: 7461057
Q1, Q2, Q3, Q4, Q5, Q6: FDMS86368-F085; PQFN8_5X6
Q7, Q9: 2N7002; SOT23; DIGIKEY# 2N7002NCT-ND
Q8: RQ3L070ATTB
R4, R28, R29: 4K7; R0805; DIGIKEY# YAG3364CT-ND
R5: 1K; R0805; DIGIKEY# YAG1240CT-ND
R13, R14, R15, R16, R18, R19, R31: 4R3; R0805; DIGIKEY# 311-4.3ARTR-ND
R17, R20: 3 mOhms; R2512-KELVIN; LCSC# C76247
R21: 200R; R0805; DIGIKEY# 13-RT0805FRE07200RLCT-ND
R22, R23, R24, R25, R26, R27, R32: 10K; R0805; DIGIKEY# YAG1239CT-ND
R37, R38: PMR18EZPJ000; RESC3216X42N
S1: SENSE; SENSE-0.6

Connections:
CAN_VDD: R4.2, R5.2; also elsewhere on the board
GND: C14.1, C16.1, IC5.3 (GND); also elsewhere on the board
MITO_PRESENCE: Q7.1 (G), R4.1, R31.1; also elsewhere on the board
unnamed: C16.2, IC5.1 (VCC), R21.2
unnamed: Q5.4 (G), R18.2
unnamed: Q6.4 (G), R19.2
unnamed: Q7.3 (D), Q9.1 (G), R5.1, R32.2
unnamed: Q3.4 (G), R15.2
unnamed: Q4.4 (G), R16.2
unnamed: Q9.3 (D), R29.1
unnamed: Q1.4 (G), R13.2
unnamed: Q2.4 (G), R14.2
unnamed: C3.2, D4.3 (C), J5.1, J5.2, J5.3, J5.4, J5.5, J5.6, Q8.1 (S_1), Q8.2 (S_2), Q8.3 (S_3), R28.1, R37.2, R38.2
PGND: C11.1, C12.1, C13.1, C15.1, C17.1, C19.1, CON19.1, CON19.2, J6.1, J6.2, J6.3, J6.4, J6.5, J6.6, Q2.1 (S), Q2.2 (S), Q2.3 (S), Q7.2 (S), Q9.2 (S), R17.2, R17.22 (2), R20.2, R20.22 (2), R31.2, R32.1, S1.SHELL (SHELLL); also elsewhere on the board
PHASE_A: J2.1, J2.2, J2.3, J2.4, J2.5, J2.6, Q3.1 (S), Q3.2 (S), Q3.3 (S), Q4.5 (D), Q4.6 (D), Q4.7 (D), Q4.8 (D), Q4.P$1 (D), R22.1; also elsewhere on the board
PHASE_A_CURRENT_SHUNT_N: R17.S1; also elsewhere on the board
PHASE_A_CURRENT_SHUNT_P: R17.S2; also elsewhere on the board
PHASE_A_GATE_HIGH: R15.1, R22.2; also elsewhere on the board
PHASE_A_GATE_LOW: R16.1, R23.2; also elsewhere on the board
PHASE_A_GND: Q4.1 (S), Q4.2 (S), Q4.3 (S), R17.1, R17.11 (1), R23.1; also elsewhere on the board
PHASE_B: J4.1, J4.2, J4.3, J4.4, J4.5, J4.6, Q5.1 (S), Q5.2 (S), Q5.3 (S), Q6.5 (D), Q6.6 (D), Q6.7 (D), Q6.8 (D), Q6.P$1 (D), R25.1; also elsewhere on the board
PHASE_B_CURRENT_SHUNT_N: R20.S1; also elsewhere on the board
PHASE_B_CURRENT_SHUNT_P: R20.S2; also elsewhere on the board
PHASE_B_GATE_HIGH: R18.1, R25.2; also elsewhere on the board
PHASE_B_GATE_LOW: R19.1, R24.2; also elsewhere on the board
PHASE_B_GND: Q6.1 (S), Q6.2 (S), Q6.3 (S), R20.1, R20.11 (1), R24.1; also elsewhere on the board
PHASE_C: J3.1, J3.2, J3.3, J3.4, J3.5, J3.6, Q1.1 (S), Q1.2 (S), Q1.3 (S), Q2.5 (D), Q2.6 (D), Q2.7 (D), Q2.8 (D), Q2.P$1 (D), R27.1; also elsewhere on the board
PHASE_C_GATE_HIGH: R13.1, R27.2; also elsewhere on the board
PHASE_C_GATE_LOW: R14.1, R26.2; also elsewhere on the board
PHASE_C_GND: R26.1, S1.IN; also elsewhere on the board
SFGKDLS: C3.1, D4.1 (A), Q8.4 (G), R28.2, R29.2
TEMPERATURE_SENSOR: C14.2, IC5.2 (OUT); also elsewhere on the board
VDC: C11.2, C12.2, C13.2, C15.2, C17.2, C19.2, CON18.1, CON18.2, Q1.5 (D), Q1.6 (D), Q1.7 (D), Q1.8 (D), Q1.P$1 (D), Q3.5 (D), Q3.6 (D), Q3.7 (D), Q3.8 (D), Q3.P$1 (D), Q5.5 (D), Q5.6 (D), Q5.7 (D), Q5.8 (D), Q5.P$1 (D), Q8.5 (D_1), Q8.6 (D_2), Q8.7 (D_3), Q8.8 (D_4), Q8.9 (D_5), R37.1, R38.1; also elsewhere on the board
VDD_5V: R21.1; also elsewhere on the board

Notes on the sheet:
PHASE_B
PHASE_A
PHASE_C
Capacitor battery
These capacitors should be placed as close as possible to the power transistors.
Temperature sensor
Place close to power mosfets
POWERSTAGE
Invalid insertion protection
R31 should be mounted if mito_presence signal is not used
Mito presence goes low when mitochondrik is inserted. Then CAN_VDD should be set to 1, which turns on Q9, which then turns on Q11 allowing VDC to power the device
CON18, CON19 may be used for connecting additional capacitor PCB if needed
Connect 1189-1510-ND (digikey#) to CON18, CON19
C3 may be tweaked if needed to slow down voltage rise pace
