Zubax/mitochondrik-evaluation-board-lv/src/MyDuck-LV.brd

## EAGLE design src/MyDuck-LV.brd (continued)

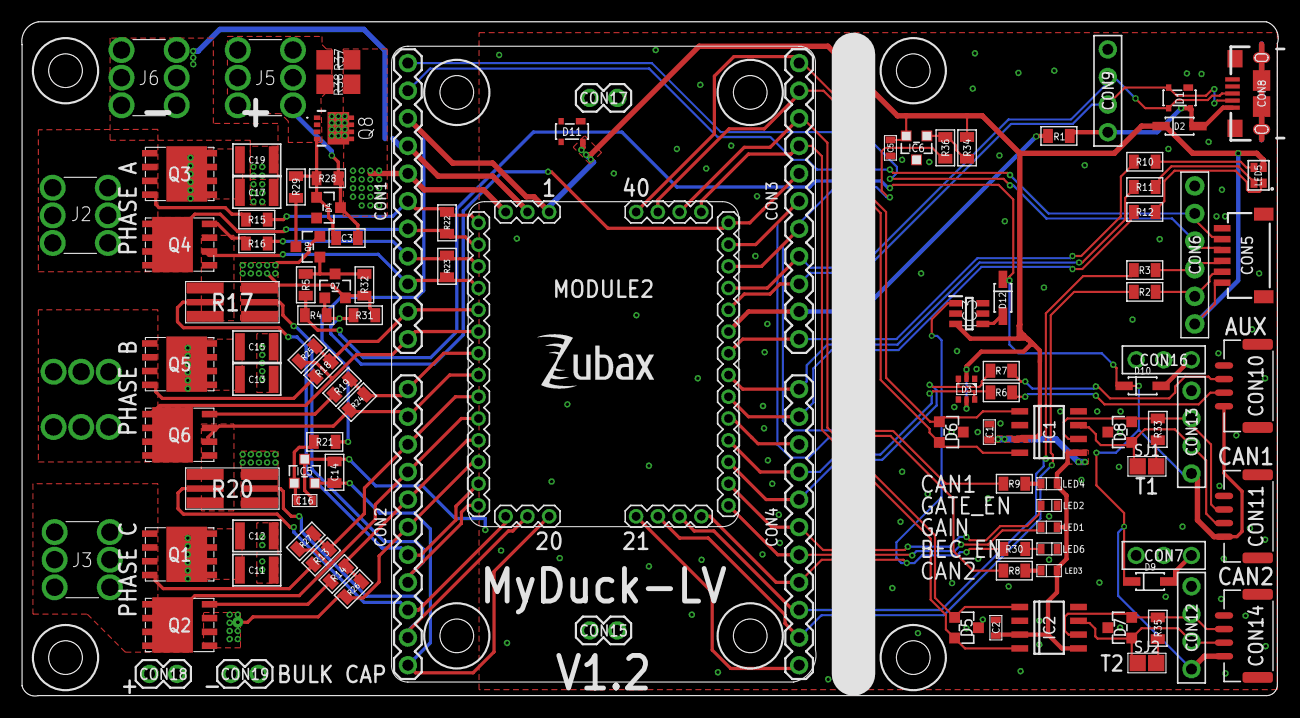
[picture p19: board MyDuck-LV.brd from above]

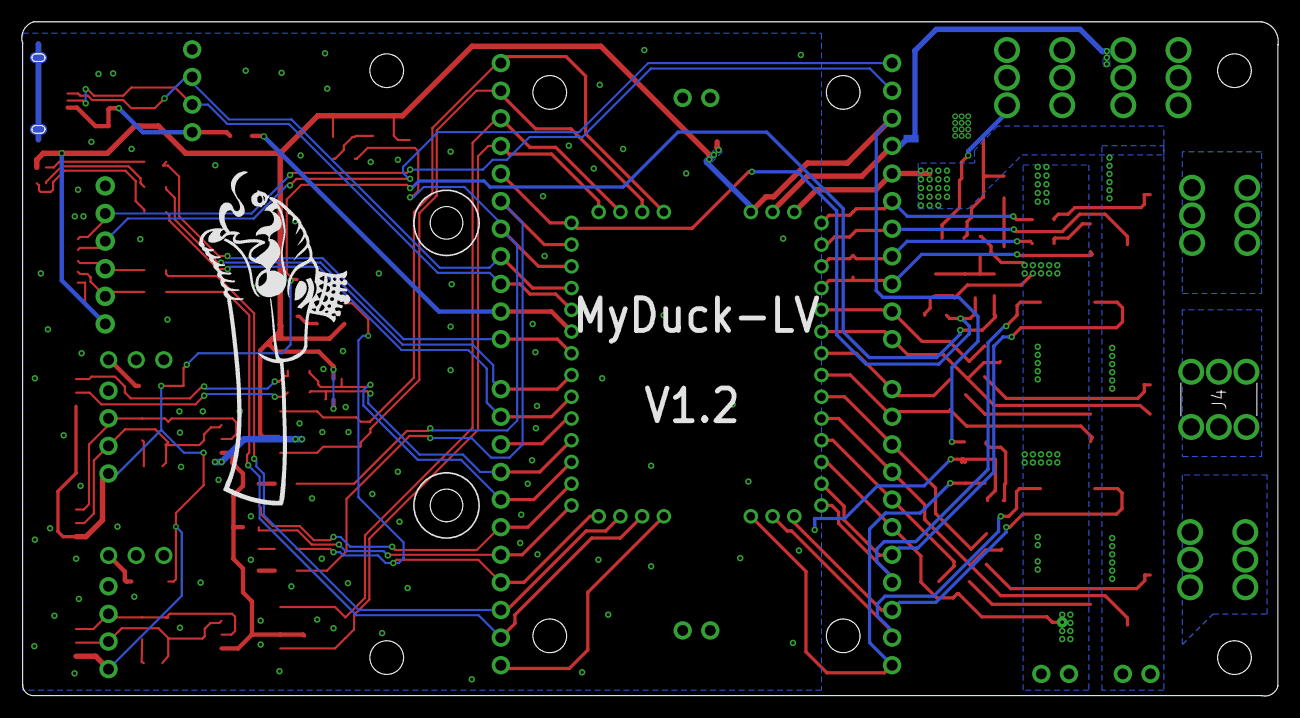
[picture p20: board MyDuck-LV.brd from below]

Board: 2 copper layers, 115.6 x 62.0 mm, 114 parts (3 on the bottom side), 78 nets.

Other parts of the board:
U$1: DRAGON-30X13
U$2: ZUBAX_LOGO_5X10
U$3: BABEL-BABEL
