Zubax/mitochondrik-evaluation-board-lv/src/riser.brd

## EAGLE design src/riser.brd (2021-01-11)

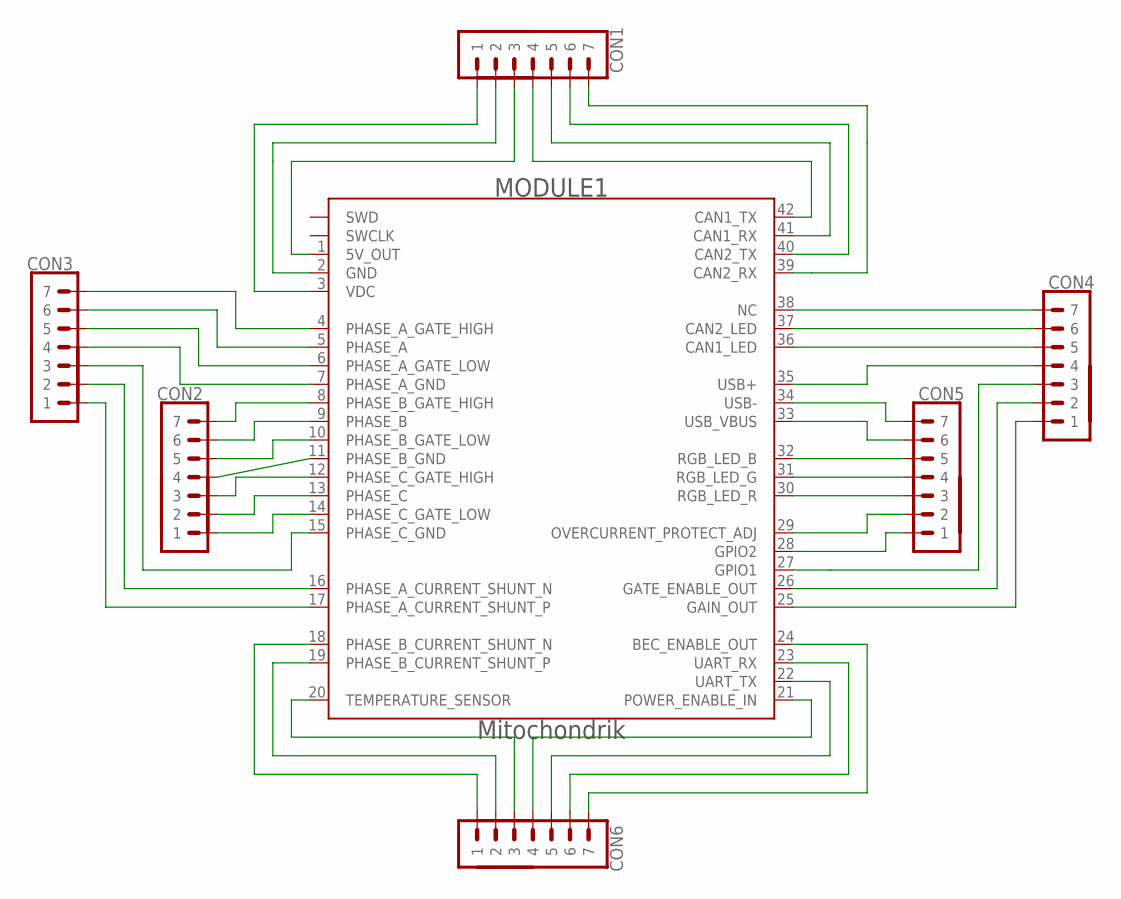
[picture p21: schematic riser.sch]

Parts:
CON1, CON2, CON3, CON4, CON5, CON6: PINHEAD_1X07-2; 1X07-PTH-2
MODULE1: MITOHONDRIQUE_POGO-POGO; MITOHONDRIQUE-POGO

Connections:
unnamed: CON1.7, MODULE1.39 (CAN2_RX)
unnamed: CON1.6, MODULE1.40 (CAN2_TX)
unnamed: CON1.5, MODULE1.41 (CAN1_RX)
unnamed: CON1.4, MODULE1.42 (CAN1_TX)
unnamed: CON1.3, MODULE1.1 (5V_OUT)
unnamed: CON1.2, MODULE1.2 (GND)
unnamed: CON1.1, MODULE1.3 (VDC)
unnamed: CON6.7, MODULE1.24 (BEC_ENABLE_OUT)
unnamed: CON6.6, MODULE1.23 (UART_RX)
unnamed: CON6.5, MODULE1.22 (UART_TX)
unnamed: CON6.4, MODULE1.21 (POWER_ENABLE_IN)
unnamed: CON6.3, MODULE1.20 (TEMPERATURE_SENSOR)
unnamed: CON6.2, MODULE1.19 (PHASE_B_CURRENT_SHUNT_P)
unnamed: CON6.1, MODULE1.18 (PHASE_B_CURRENT_SHUNT_N)
unnamed: CON3.7, MODULE1.4 (PHASE_A_GATE_HIGH)
unnamed: CON3.6, MODULE1.5 (PHASE_A)
unnamed: CON3.4, MODULE1.7 (PHASE_A_GND)
unnamed: CON3.5, MODULE1.6 (PHASE_A_GATE_LOW)
unnamed: CON3.1, MODULE1.17 (PHASE_A_CURRENT_SHUNT_P)
unnamed: CON3.2, MODULE1.16 (PHASE_A_CURRENT_SHUNT_N)
unnamed: CON3.3, MODULE1.15 (PHASE_C_GND)
unnamed: CON2.1, MODULE1.14 (PHASE_C_GATE_LOW)
unnamed: CON2.2, MODULE1.13 (PHASE_C)
unnamed: CON2.3, MODULE1.12 (PHASE_C_GATE_HIGH)
unnamed: CON2.4, MODULE1.11 (PHASE_B_GND)
unnamed: CON2.5, MODULE1.10 (PHASE_B_GATE_LOW)
unnamed: CON4.7, MODULE1.38 (NC)
unnamed: CON2.7, MODULE1.8 (PHASE_B_GATE_HIGH)
unnamed: CON2.6, MODULE1.9 (PHASE_B)
unnamed: CON4.6, MODULE1.37 (CAN2_LED)
unnamed: CON4.5, MODULE1.36 (CAN1_LED)
unnamed: CON4.3, MODULE1.27 (GPIO1)
unnamed: CON4.4, MODULE1.35 (USB+)
unnamed: CON4.2, MODULE1.26 (GATE_ENABLE_OUT)
unnamed: CON4.1, MODULE1.25 (GAIN_OUT)
unnamed: CON5.1, MODULE1.28 (GPIO2)
unnamed: CON5.2, MODULE1.29 (OVERCURRENT_PROTECT_ADJ)
unnamed: CON5.3, MODULE1.30 (RGB_LED_R)
unnamed: CON5.4, MODULE1.31 (RGB_LED_G)
unnamed: CON5.5, MODULE1.32 (RGB_LED_B)
unnamed: CON5.6, MODULE1.33 (USB_VBUS)
unnamed: CON5.7, MODULE1.34 (USB-)
SWCLK: MODULE1.SWCLK
SWD: MODULE1.SWDIO (SWD)

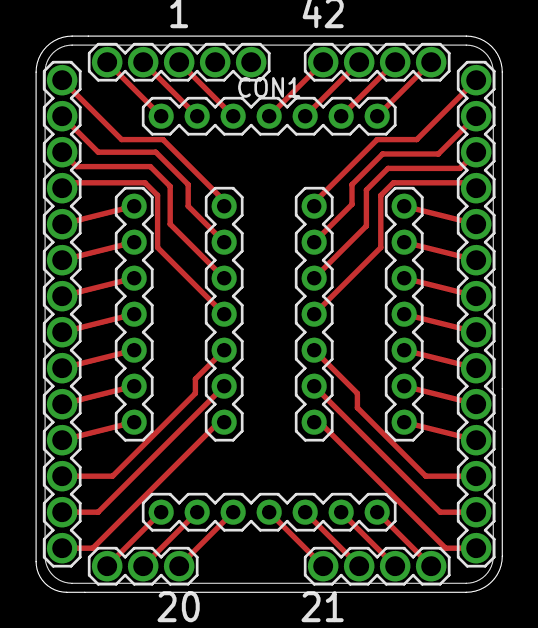
[picture p22: board riser.brd from above]

Board: 2 copper layers, 25.9 x 30.9 mm, 7 parts (0 on the bottom side), 42 nets.
