Zubax/mitochondrik-evaluation-board-lv/(commit log)

2020-12-28 USB PLS connector placement fixed
2020-12-28 BOM updates
2021-01-05 Create toggle clamp.png
2021-01-06 1-wire EEPROM added to CAN1 LED line in case it will be some day implemented in firmware
2021-01-08 solder joint for termination resistors for CAN buses added
2021-01-08 Additional TVS diode footprint added
2021-01-11 Silkscreen update
2021-01-11 Adapter PCB added
2021-01-18 MOSFETs replaced
2021-01-20 Mito footprint update
2021-01-27 Update JIG.brd
    Couple mounting holes for Babel-Babel plastic mount added.
2021-01-28 USB connector type updated
2021-01-29 Resistor values updated
2021-02-10 Massive attribute update (#3)
    * Massive attribute update
    * renaming
    * connectors attribute updates
    * CAM and DRU files added
2021-07-29 usb pinout fix #5 (#8)
    * usb pinout fix #5
    * fixes to issue #4
    * usb vbus trace width fix
2021-08-16 First release (#9)
    * repo restructered
    * * repo restructured
    * README.md updated
    * Update manufacturing.md
    * Update manufacturing.md
    * Update manufacturing.md
    * Create flashing
    * Rename flashing to flashing.md
    * Update README.md
    * Update README.md
    * Delete flashing.md
    * Delete toggle clamp.png
    * Update README.md
    * Update README.md
    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
2023-02-17 bug fix (#14)
    * bug fix
    * sync
    * update changelog
    * protection diode added to CANVDD
2023-03-03 screw terminal added (#16)
    * screw terminal added
    * new holder added
    * change in 3d parts
    * holder model updated
    * holder redesigned
    * added connector to adapter
2023-03-10 FET replaced (#19)
2023-03-10 silkscreen (#20)
2023-05-10 v1.2 assembly (#25)
    closes #18 - will change repo name to MEB-LV once this is merged
    closes #23
    closes #22 - @abualkasim-bakeer did it
    ---------
2023-08-01 changes for v1.2 (#40)
    created new pogo jig - changed height to 5.5mm to account for ribbon
    connectors (option 1), closes #39
    removed legs in pogo jig, closes #31
    removed wings for the top 3D part, closes #30
    added countersunk holes for 3D parts, closes #32
    updated assembly instructions, closes #29
    moved power terminal silkscreen labels so they are seen, closes #33
    increased thickness of 3D holders & updated assembly instructions,
    closes #34
    updated schematic, DNP R31 in manufacturing variant, closes #35
    added RGB LED instructions, closes #41
    updated 3D holders - reduced magnet distance, added steel sheet slot,
    widened screw holes to 3.4 mm, [MEBLV-4]
    updated bottom 3D holder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
